jjarokergc/OJAquaFlux/AQUA_Flux_Colgate/design_files/wiring/wiring.png

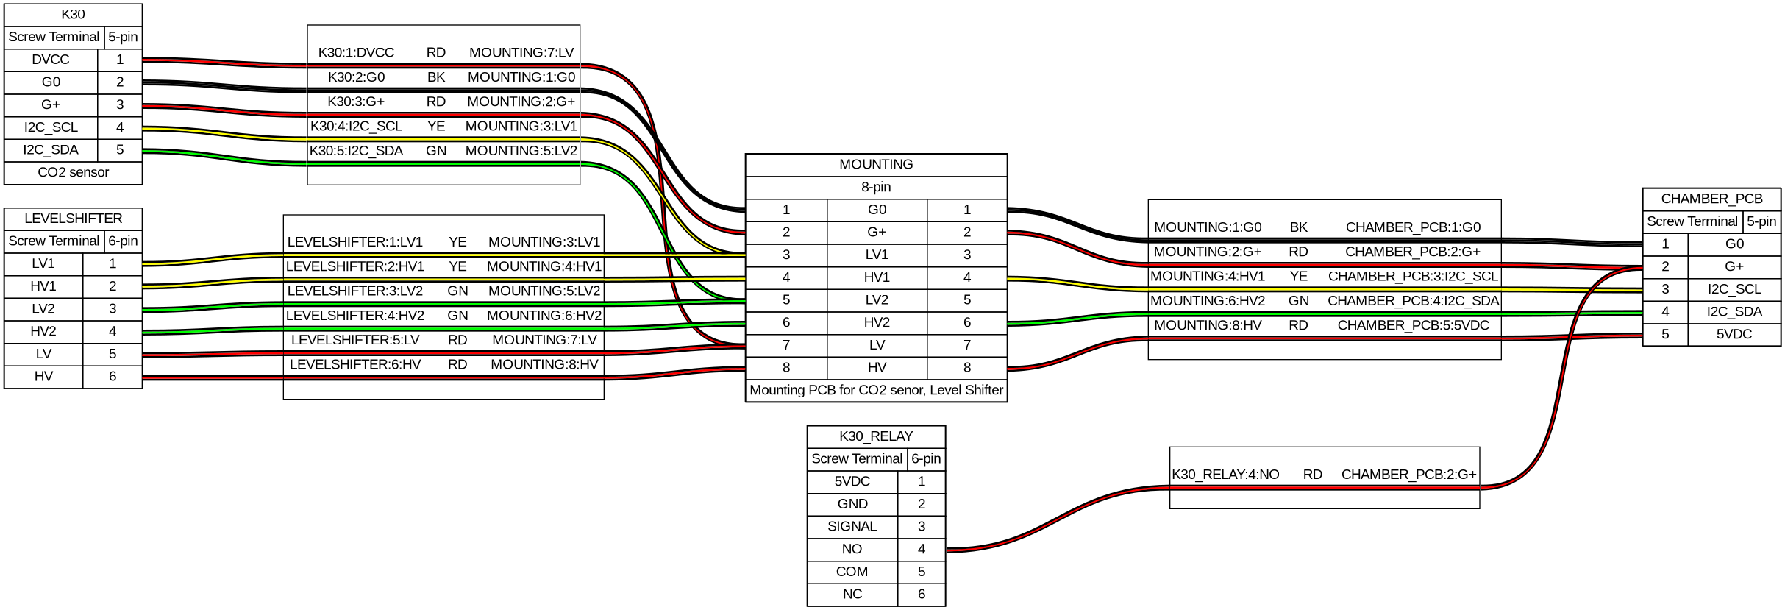
AQUA_Flux_Colgate/design_files/wiring/wiring.png
