jjarokergc/OJAquaFlux/AQUA_Flux_Colgate/setupK30.ino

// TODO
// Refactor into a class
// Refactor readK30 to use same class

// setupK30.ino
//
// K30 CO2 sensor setup: I2C address verification/change and error status check
//
// Static helpers (USE_K30 only):
//   k30ReadRAM()       — shared Wire read-RAM protocol
//   k30WriteEEPROM()   — shared Wire write-EEPROM protocol (for address change)
//   readK30I2CAddress()  — read configured address from RAM 0x0020 via 0x7F
//   ensureK30Address()   — verify address == K30_I2C_ADDR; write + power-cycle if not
//   checkK30ErrorStatus() — read error status register (RAM 0x1E); halt on fatal bits
//
// Reference: SenseAir K30 datasheet TDE4700, PSP110

#define K30_POWER_DOWN_MS 10000UL // ms to wait after relay OFF before turning back on

// Shared error message buffer used by all helpers below.
#if USE_K30
static char k30errbuf[64];
#endif

// ---------------------------------------------------------------------------
// Wire primitives  (USE_K30 only)
// ---------------------------------------------------------------------------
#if USE_K30

// Send a Read-RAM command and write `numRead` data bytes into `outBuf` (MSB first).
// `i2cAddr`  — sensor I2C address (pass 0x7F for "any sensor").
// `ramAddr`  — 16-bit K30 RAM address to read.
// `outBuf`   — caller-provided buffer; must be at least `numRead` bytes.
// `numRead`  — number of data bytes to read (1–16); default 2.
//              Encoded in the low nibble of the command byte (TDE4700): values
//              1–15 map directly; 16 maps to nibble 0x0 (i.e. command 0x20).
// Retries up to K30_READ_RAM_RETRIES times on unexpected status bytes — the K30
// can return a stale Write EEPROM response (0x31) on the first read after an
// address change, which clears on retry.
// Calls error() and halts on transmission errors, byte-count mismatches,
// checksum failures, or if all retries are exhausted.
#define K30_READ_RAM_RETRIES 3
#define K30_READ_RAM_RETRY_DELAY_MS 100

static void k30ReadRAM(uint8_t i2cAddr, uint16_t ramAddr,
                       uint8_t *outBuf, uint8_t numRead = 2)
{
  if (numRead == 0 || numRead > 16)
  {
    snprintf(k30errbuf, sizeof(k30errbuf),
             "k30ReadRAM: numRead %d out of range (1-16)", numRead);
    error(k30errbuf);
  }

  byte cmd[4];
  cmd[0] = 0x20 | (numRead & 0x0F); // Read RAM, numRead data bytes (TDE4700)
  cmd[1] = (ramAddr >> 8) & 0xFF;
  cmd[2] = ramAddr & 0xFF;
  cmd[3] = cmd[0] + cmd[1] + cmd[2];

  for (uint8_t attempt = 0; attempt < K30_READ_RAM_RETRIES; attempt++)
  {

    // Flush the wire
    DEBUG_PRINT(F("Flushing I2C Bus before sending Read Ram command..."));
    while (Wire.available())
    {
      byte c = Wire.read();
      DEBUG_PRINT(c, HEX);
      DEBUG_PRINT(F("..."));
    }
    DEBUG_PRINTLN(F("DONE"));

    DEBUG_PRINT(F("Sending K30 Read RAM(0x"));
    DEBUG_PRINT(i2cAddr, HEX);
    DEBUG_PRINT(F("): { "));
    Wire.beginTransmission(i2cAddr);
    for (uint8_t i = 0; i < sizeof(cmd); i++)
    {
      DEBUG_PRINT(cmd[i], HEX);
      DEBUG_PRINT(F(" "));
      Wire.write(cmd[i]);
    }
    DEBUG_PRINTLN(F("}"));

    byte err = Wire.endTransmission();
    if (err != 0)
    {
      snprintf(k30errbuf, sizeof(k30errbuf),
               "K30 readRAM 0x%04X: transmission error %d", ramAddr, err);
      error(k30errbuf);
    }

    // The K30 datasheet specifies ≥20 ms for the sensor to finish writing
    // the result to RAM before you read it back.
    delay(30);

    //
    // K30 Response
    //
    // Expect numRead + 2 bytes (Section 5.3 Read Ram)
    //  Byte 1         - Status (0x21 "Read Complete" or 0x20 "Read Incomplete")
    //  Bytes 2..N+1   - Data (MSB first, numRead bytes)
    //  Byte N+2       - Checksum (sum of all preceding bytes, truncated to 8 bits)

    uint8_t expected = numRead + 2;
    uint8_t received = Wire.requestFrom(i2cAddr, expected);
    if (received != expected)
    {
      snprintf(k30errbuf, sizeof(k30errbuf),
               "K30 readRAM 0x%04X: expected %d bytes, got %d", ramAddr, expected, received);
      error(k30errbuf);
    }

    // Read response into buf; accumulate checksum over all bytes except the last
    uint8_t buf[18]; // status (1) + data (up to 16) + checksum (1)
    uint8_t checksum = 0;
    DEBUG_PRINT(F("Received Data on I2C Bus: "));
    for (uint8_t i = 0; i < expected; i++)
    {
      buf[i] = Wire.read();
      DEBUG_PRINT(buf[i], HEX);
      DEBUG_PRINT(F(" "));
      if (i < expected - 1) // accumulate all bytes except the checksum byte itself
        checksum += buf[i];
    }
    DEBUG_PRINTLN(F("DONE"));

    // Check for stray data on i2c
    DEBUG_PRINT(F("Checking for more data on I2C Bus..."));
    while (Wire.available())
    {
      byte c = Wire.read();
      DEBUG_PRINT(c, HEX);
      DEBUG_PRINT(F("..."));
    }
    DEBUG_PRINTLN(F("DONE"));

    if (buf[0] != 0x21)
    {
      DEBUG_PRINT(F("K30 readRAM unexpected status 0x"));
      DEBUG_PRINT(buf[0], HEX);
      DEBUG_PRINTLN(F(", retrying..."));
      delay(K30_READ_RAM_RETRY_DELAY_MS);
      continue; // retry — K30 may return stale EEPROM response (0x31) after address change
    }

    if (checksum != buf[expected - 1])
    {
      snprintf(k30errbuf, sizeof(k30errbuf),
               "K30 readRAM 0x%04X: checksum fail", ramAddr);
      error(k30errbuf);
    }

    for (uint8_t i = 0; i < numRead; i++)
      outBuf[i] = buf[1 + i];
    return; // success
  }

  snprintf(k30errbuf, sizeof(k30errbuf),
           "K30 readRAM 0x%04X: bad status after %d retries", ramAddr, K30_READ_RAM_RETRIES);
  error(k30errbuf);
}

// Send a Write-EEPROM command (TDE4700 Section 5.4) to set a 1-byte value, then
// read back the 2-byte response to confirm the write completed.
// NOTE: This function is limited to writing 1 byte only.
// `i2cAddr`    — target sensor (pass 0x7F for "any sensor" on a point-to-point bus).
// `eepromAddr` — 16-bit K30 EEPROM address (e.g. 0x0000 = I2C slave address, p.19).
// `val`        — 1-byte value to write.
// Calls error() and halts on transmission failure or if the sensor reports incomplete.
//
// Request frame (5 bytes):
//   0x31 | addrMSB | addrLSB | data | checksum
//   0x31 = command nibble 0x3 (Write EE) | count nibble 0x1 (1 byte)
//   checksum = sum of first 4 bytes, truncated to 8 bits
//
// Response frame (2 bytes, read after t_WAIT ≥ 20 ms):
//   [0] status: 0x31 = write complete, 0x30 = write incomplete (sensor busy)
//   [1] checksum = status byte
static void k30WriteEEPROM(uint8_t i2cAddr, uint16_t eepromAddr, uint8_t val)
{
  byte cmd[5];
  cmd[0] = 0x31;                              // Write EEPROM, 1 data byte (TDE4700)
  cmd[1] = (eepromAddr >> 8) & 0xFF;          // address MSB
  cmd[2] = eepromAddr & 0xFF;                 // address LSB
  cmd[3] = val;                               // data byte
  cmd[4] = cmd[0] + cmd[1] + cmd[2] + cmd[3]; // checksum

  Wire.beginTransmission(i2cAddr);

  // Flush the wire
  DEBUG_PRINT(F("Flushing I2C Bus before Write EEPROM command..."));
  while (Wire.available())
  {
    byte c = Wire.read();
    DEBUG_PRINT(c, HEX);
    DEBUG_PRINT(F("..."));
  }
  DEBUG_PRINTLN(F("DONE"));

  DEBUG_PRINT(F("Sending K30 EEPROM write: { "));
  for (uint8_t i = 0; i < sizeof(cmd); i++)
  {
    Wire.write(cmd[i]);
    DEBUG_PRINT(cmd[i], HEX);
    DEBUG_PRINT(F(" "));
  }
  DEBUG_PRINTLN(F("}"));
  byte err = Wire.endTransmission();
  if (err != 0)
  {
    snprintf(k30errbuf, sizeof(k30errbuf),
             "K30 writeEEPROM 0x%04X: transmission error %d", eepromAddr, err);
    error(k30errbuf);
  }

  delay(30); // t_WAIT: sensor commits EEPROM write during this window (TDE4700 Table 6)

  //
  // K30 Response to Write EEPROM
  //
  // Expect 2 Bytes (Section 5.4 Write EEPROM)
  //  Byte 1 - Status (0x31 "Write Complete" or 0x30 "Write Incomplete")
  //  Byte 2 - Checksum

  // Read 2-byte response: [status, checksum]
  byte received = Wire.requestFrom(i2cAddr, (uint8_t)2);
  if (received != 2)
  {
    snprintf(k30errbuf, sizeof(k30errbuf),
             "K30 writeEEPROM 0x%04X: response expected 2 bytes, got %d", eepromAddr, received);
    error(k30errbuf);
  }
  byte status = Wire.read();
  byte respCsum = Wire.read();
  DEBUG_PRINT(F("Write EEPROM Response: status=0x"));
  DEBUG_PRINT(status, HEX);
  DEBUG_PRINT(F(" checksum=0x"));
  DEBUG_PRINTLN(respCsum, HEX);

  // Check for stray data after reading expected bytes
  DEBUG_PRINT(F("Checking for extra data on I2C Bus..."));
  while (Wire.available())
  {
    byte c = Wire.read();
    DEBUG_PRINT(c, HEX);
    DEBUG_PRINT(F("..."));
  }
  DEBUG_PRINTLN(F("DONE"));
  if (status != 0x31)
  {
    snprintf(k30errbuf, sizeof(k30errbuf),
             "K30 writeEEPROM 0x%04X: write incomplete, status 0x%02X", eepromAddr, status);
    error(k30errbuf);
  }
  DEBUG_PRINTLN(F("K30 EEPROM write complete"));
}

// ---------------------------------------------------------------------------
// Address management
// ---------------------------------------------------------------------------

// Read the K30's currently configured I2C address from RAM 0x0020.
// Uses 0x7F so this works regardless of the sensor's current address.
static uint8_t readK30I2CAddress()
{
  uint8_t buf[1] = {0};
  k30ReadRAM(0x7F, 0x0020, buf, 1);
  return buf[0];
}

// Verify the K30's configured address matches K30_I2C_ADDR.
// If it does not match:
//   - Writes K30_I2C_ADDR to EEPROM register 0x0000 via 0x7F.
//   - HAS_K30_RELAY=1: power-cycles the relay, then re-reads to confirm.
//   - HAS_K30_RELAY=0: instructs the operator to power-cycle manually, then halts.
static bool ensureK30Address()
{
  uint8_t cur = readK30I2CAddress();

  if (cur == K30_I2C_ADDR)
  {
    LOG_STREAM.print(F("K30 I2C address: 0x"));
    LOG_STREAM.print(cur, HEX);
    LOG_STREAM.println(F(" OK"));
    return true;
  }

  LOG_STREAM.print(F("K30 I2C address mismatch: found 0x"));
  LOG_STREAM.print(cur, HEX);
  LOG_STREAM.print(F(", expected 0x"));
  LOG_STREAM.println(K30_I2C_ADDR, HEX);
  LOG_STREAM.println(F("Writing new address to K30 EEPROM..."));

  k30WriteEEPROM(0x7F, 0x0000, K30_I2C_ADDR);
  DEBUG_PRINT(F("Waiting for EEPROM to Finish Writing..."));
  delay(1000); // allow physical EEPROM write to complete before cutting power
  DEBUG_PRINTLN(F("Done"));

#if HAS_K30_RELAY
  LOG_STREAM.print(F("Power cycling K30 to apply address change...Off"));
  k30RelayOff();
  delay(K30_POWER_DOWN_MS);
  LOG_STREAM.println(F("On...waiting for K30 to stabilize..."));
  k30RelayOn(); // Wait to allow the K30 to stabilize after the power cycle
  LOG_STREAM.println(F("done"));

  uint8_t newI2CAddress = readK30I2CAddress();

  if (newI2CAddress != K30_I2C_ADDR)
  { // ERROR - Address not set
    snprintf(k30errbuf, sizeof(k30errbuf),
             "K30 address not set after power cycle (got 0x%02X)", newI2CAddress);
    LOG_STREAM.println(k30errbuf);
    return false;
  }
  LOG_STREAM.print(F("K30 I2C address set to 0x"));
  LOG_STREAM.println(newI2CAddress, HEX);
  return true;
#else
  LOG_STREAM.println(F("Power cycle the K30 manually to apply the address change,"));
  LOG_STREAM.println(F("then reboot the Arduino."));
  error("K30 requires manual power cycle to apply address change");
#endif
}

// ---------------------------------------------------------------------------
// Error status check
// ---------------------------------------------------------------------------

// Reads the K30 error status register (RAM 0x1E).
// Uses K30_I2C_ADDR — called after ensureK30Address() has confirmed the address.
// Logs a human-readable report. Halts on any set bit (all indicate sensor fault).
static bool checkK30ErrorStatus()
{
  uint8_t statusBuf[1] = {0};
  k30ReadRAM(K30_I2C_ADDR, 0x001E, statusBuf, 1);
  uint8_t status = statusBuf[0];

  LOG_STREAM.print(F("K30 error status (0x1E): 0x"));
  if (status < 0x10)
    LOG_STREAM.print(F("0"));
  LOG_STREAM.print(status, HEX);

  if (status == 0x00)
  {
    LOG_STREAM.println(F("...K30: OK"));
    return true;
  }

  LOG_STREAM.println(F("...K30: FAILED"));
  bool isGoodK30 = false; // Terminate program only for fatal errors
  // Bit definitions
  // https://rmtplusstoragesenseair.blob.core.windows.net/docs/publicerat/PSP110.pdf
  // Page 8
  if (status & 0x01)
    LOG_STREAM.println(F("Fatal error (bit 0) Error Code 1"));

  if (status & 0x02)
    LOG_STREAM.println(F("Offset regulation error (bit 1) Error Code 2"));

  if (status & 0x04)
  {
    LOG_STREAM.println(F("Algorithm error (bit 2) Error Code 4"));
    LOG_STREAM.println(F("  Indicates wrong EEPROM configuration"));
    LOG_STREAM.println(F("  Check settings & reconfigure with software tools"));
  }

  if (status & 0x08)
  {
    LOG_STREAM.println(F("Output error (bit 3) Error Code 8"));
    LOG_STREAM.println(F("  Detected errors during output signals calculation & generation"));
    LOG_STREAM.println(F("  Check connections & loads of outputs"));
  }

  if (status & 0x10)
  {
    LOG_STREAM.println(F("Self-diagnostic error (bit 4) Error Code 16"));
    LOG_STREAM.println(F("  May indicate the need to zero calibration or sensor replacement"));
    LOG_STREAM.println(F("  Check detailed self-diagnostic status with software tools"));
    isGoodK30 = true;
    miscalibratedK30 = true;
  }

  if (status & 0x20)
  {
    LOG_STREAM.println(F("Out of range (bit 5) Error Code 32"));
    LOG_STREAM.println(F("  Accompanies most of the other errors. Resets automatically."));
    LOG_STREAM.println(F("  Can also indicate overload or failures of sensors and inputs."));
    LOG_STREAM.println(F("  Perform CO2 background calibration. See documentation."));
    isGoodK30 = true;
    miscalibratedK30 = true;
  }

  if (status & 0x40)
    LOG_STREAM.println(F("Memory error (bit 6) Error Code 64"));

  if (status & 0x80)
  {
    LOG_STREAM.print(F("Reserved: unknown flag (bit 7) 0x"));
    LOG_STREAM.println(status & 0x80, HEX);
  }

  return isGoodK30;
}
#endif // USE_K30

// ---------------------------------------------------------------------------
// setupK30()  — called once from setup()
// ---------------------------------------------------------------------------
void setupK30()
{
#if USE_K30
  bool k30GoodAddress = ensureK30Address();   // verify/set I2C address via 0x7F; power-cycle if needed
  bool k30GoodStatus = checkK30ErrorStatus(); // confirm no fatal faults at the confirmed address

  if (!k30GoodAddress || !k30GoodStatus)
    error("K30 Failed Setup");
#else
  DEBUG_PRINTLN(F("DEBUG - K30 CO2 sensor disabled"));
#endif // USE_K30
}
