jjarokergc/OJAquaFlux/AQUA_Flux_Colgate/readK30_CO2_withRetry.ino

// TODO
// Refactor readK30_CO2_withRetry()
// Rename to readK30_CO2()
// Helper function
//  uint16_t function readK30Ram_withRetry(uint8_t i2cAddr, uint16_t ramAddr, uint8_t readNum)
//  return uint16_t value
//

// Arduino sketch for reading Sensair K30 CO2 sensor over I2C and sending data via XBee
// or Serial. Includes a retry mechanism and bus recovery to handle common I2C issues
// with the K30 when used with long wires or in electrically noisy environments.
//
// Error handling and expected behavior is designed according to Sensair data sheet:
// https://rmtplusstoragesenseair.blob.core.windows.net/docs/Dev/publicerat/TDE4700.pdf

// Datasheet Timing Constants
#define CMD_DELAY_MS 20     // K30 datasheet: ≥20 ms after write
#define RETRY_BACKOFF_MS 50 // extra wait between retries

// Retry configuration
#define MAX_RETRIES 3 // Retries before resetting I2C bus

// Returns CO2 in ppm as int16_t, or 0 on failure.
#if USE_K30
int16_t readK30_CO2_withRetry()
{
  for (int retry = 0; retry < MAX_RETRIES; retry++)
  {
    Wire.beginTransmission(K30_I2C_ADDR);

    //
    // K30 Request Command
    //
    // Read Ram
    //  Byte 1 - Command 0x22 (ReadRam with 2 data bytes)
    //  Byte 2-3 - address 0x0008 ("Space CO2")
    //  Byte 4 - checksum
    Wire.write(0x22); // 7:4 Command bits: 0x2 = read; 3:0 Num of Data bytes to read: 0x2 = 2 bytes (MSB + LSB)
    Wire.write(0x00); // Address MSB
    Wire.write(0x08); // Address LSB
    // Checksum = sum of all command bytes (0x22 + 0x00 + 0x08 = 0x2A).
    Wire.write(0x2A); // Checksum

    uint8_t err = Wire.endTransmission();
    if (err != 0)
    {
      // err codes: 1=data too long, 2=NACK on address, 3=NACK on data, 4=other
      LOG_STREAM.print(F("endTransmission error: "));
      LOG_STREAM.println(err);
      delay(RETRY_BACKOFF_MS);
      continue;
    }

    // The K30 datasheet specifies ≥20 ms for the sensor to finish writing
    // the result to RAM before you read it back. The original 10 ms caused
    // intermittent checksum failures.
    delay(CMD_DELAY_MS);

    //
    // K30 Response
    //
    // Expect 4 Bytes (Section 5.3 Read Ram)
    //  Byte 1 - Status (0x21 "Read Complete" or 0x22 "Read Incomplete")
    //  Byte 2-3 - Data (MSB + LSB)
    //  Byte 4 - Checksum

    // Fill wire buffer with response from K30
    uint8_t received = Wire.requestFrom(K30_I2C_ADDR, (uint8_t)4); // cast '4' to uint8_t to avoid warning about signed/unsigned mismatch

    // Confirm we got 4 bytes back; if not, something went wrong at the I2C level.
    if (received != 4)
    { // alternative: Wire.available() != 4
      LOG_STREAM.print(F("ERROR: Expected 4 bytes, got "));
      LOG_STREAM.println(received);
      // Drain any leftover bytes to avoid poisoning the next transaction.
      LOG_STREAM.print(F("Flushing I2C buffer..."));
      while (Wire.available())
        Wire.read(); // flush partial data
      LOG_STREAM.println(F("done"));
      delay(RETRY_BACKOFF_MS);
      continue;
    }

    // Timeout-guarded read — prevents infinite loop if sensor stops clocking
    // Load the wire buffer into an array for processing
    uint8_t buf[4];
    unsigned long startMs = millis();
    int bytesRead = 0;

    while (bytesRead < 4 && (millis() - startMs) < I2C_TIMEOUT_MS)
    {
      if (Wire.available() > 0)
      {
        buf[bytesRead++] = Wire.read();
      }
      else
      {
        delayMicroseconds(100); // Prevent 100% CPU utilization
      }
    }

    // Expect buffer to be loaded within timeout
    // This is a redundant check given the earlier check on Wire.requestFrom(),
    // but is used here to guard against and troubleshoot I2C lockups
    if (bytesRead != 4)
    {
      LOG_STREAM.print(F("ERROR: Timeout Occurred. Loaded "));
      LOG_STREAM.print(bytesRead);
      LOG_STREAM.println(F(" bytes instead of 4"));
      LOG_STREAM.print(F("Flushing I2C buffer..."));
      while (Wire.available())
        Wire.read(); // flush partial data
      LOG_STREAM.println(F("done"));
      delay(RETRY_BACKOFF_MS);
      continue; // retry
    }

    // Expect status byte 0x21 "Read Complete"
    if (buf[0] != 0x21)
    {
      LOG_STREAM.print(F("ERROR: Sensor status indicates read incomplete: 0x"));
      LOG_STREAM.println(buf[0], HEX);
      delay(RETRY_BACKOFF_MS);
      continue;
    }

    // Verify checksum
    uint8_t checksum = buf[0] + buf[1] + buf[2];
    if (checksum != buf[3])
    {
      LOG_STREAM.println(F("ERROR: Checksum fail"));
      delay(RETRY_BACKOFF_MS);
      continue;
    }

    // Assemble CO2 value from MSB and LSB
    // The expression (buf[1] << 8) promotes to int but shifts into or past the
    // sign bit for any value ≥ 128 — undefined behavior in C/C++.
    // For CO2 readings above ~32767 ppm (unlikely but possible in fault modes)
    // the result could be spuriously negative. Fixed by casting first
    uint16_t co2 = ((uint16_t)buf[1] << 8) | buf[2];

    // Expect CO2 in a reasonable range for ambient air; if not, something went wrong
    if (co2 == 0 || co2 > 10000)
    { // 0 ppm is invalid; >10000 is out of K30 range
      LOG_STREAM.print(F("ERROR: Invalid CO2 reading: "));
      LOG_STREAM.println(co2);
      delay(RETRY_BACKOFF_MS);
      continue;
    }

    // Successful read with valid checksum and plausible CO2 value
    return co2;
  }
  return 0; // indicate failure after retries
}
#endif
