jjarokergc/OJAquaFlux/(commit log)

2026-03-29 update rtc 24-hr error handling to work around library limitation
    [AQUA_Flux_Colgate.ino, setRtcDate.ino, setupLogging.ino]
2026-03-29 fix buffer size for i2c read
    [setupK30.ino, xbeeCommands.ino]
2026-03-29 update wiring diagram
2026-03-29 updated wiring diagram
    [wiring.bom.tsv]
